giancarlotf/pi3a/Unity/simimg.jpeg

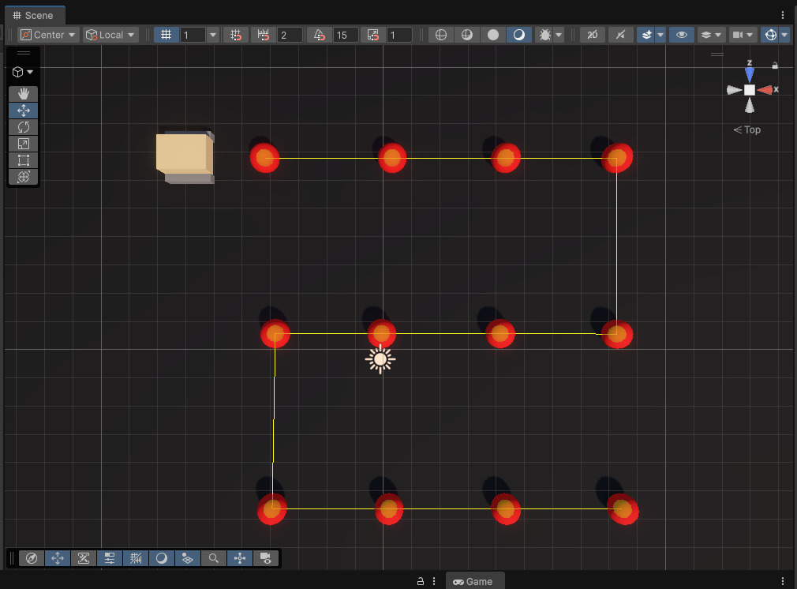
Unity/simimg.jpeg
