giancarlotf/pi3a/Fusion360/3d-models/Disco_Rodagem.step

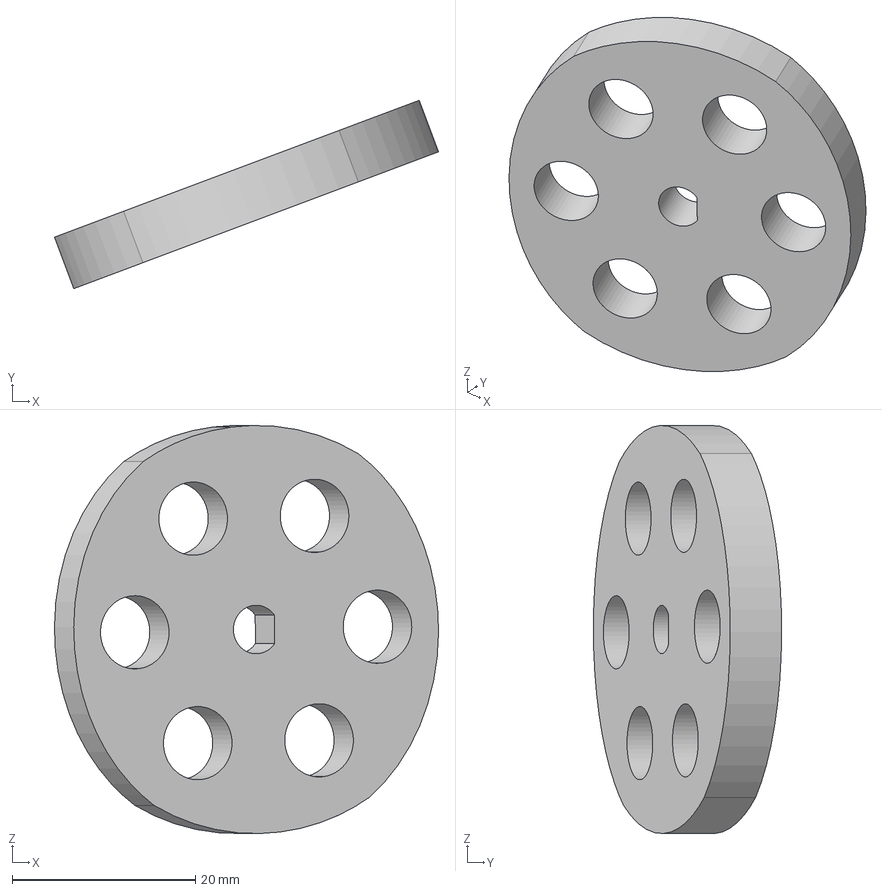
[picture p7: CAD file, 2026-06-23]
Fusion360/3d-models/Disco_Rodagem.step
42.0 x 20.6 x 44.6 mm
