giancarlotf/pi3a/KiCad/ESP8266-01_ESP-01/ESP8266-01_ESP-01.step

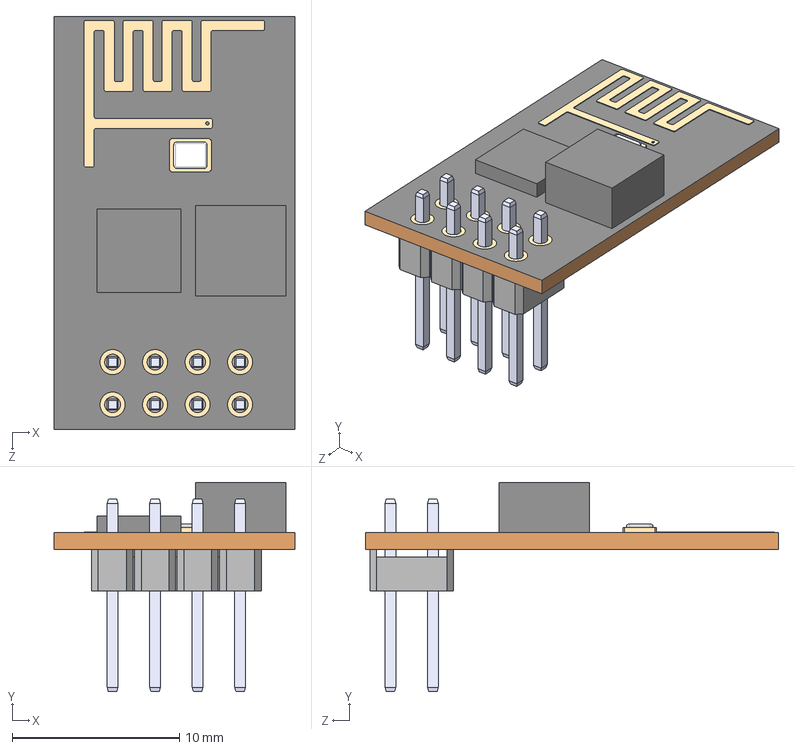
[picture p8: CAD file, 2026-05-04]
KiCad/ESP8266-01_ESP-01/ESP8266-01_ESP-01.step
14.4 x 12.5 x 24.7 mm
