giancarlotf/pi3a/KiCad/HC-SR04/HC-SR04.step

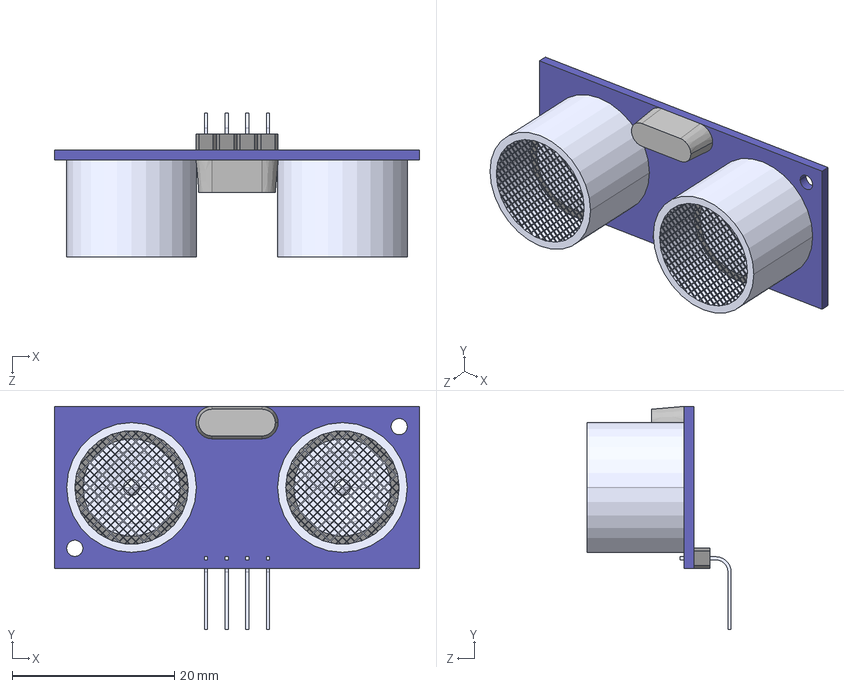
[picture p9: CAD file, 2026-05-04]
KiCad/HC-SR04/HC-SR04.step
45.0 x 27.5 x 17.8 mm
