giancarlotf/pi3a/Fusion360/3d-models/Suporte_Eixo_Disco.step

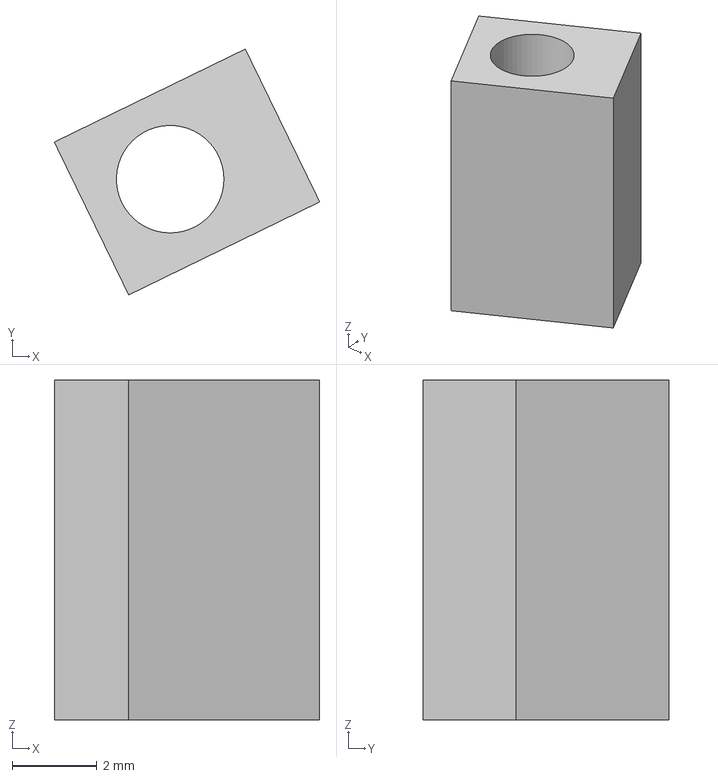
[picture p10: CAD file, 2026-06-23]
Fusion360/3d-models/Suporte_Eixo_Disco.step
6.25 x 5.79 x 8.00 mm
