giancarlotf/pi3a/Fusion360/3d-models/Haste_Disco.step

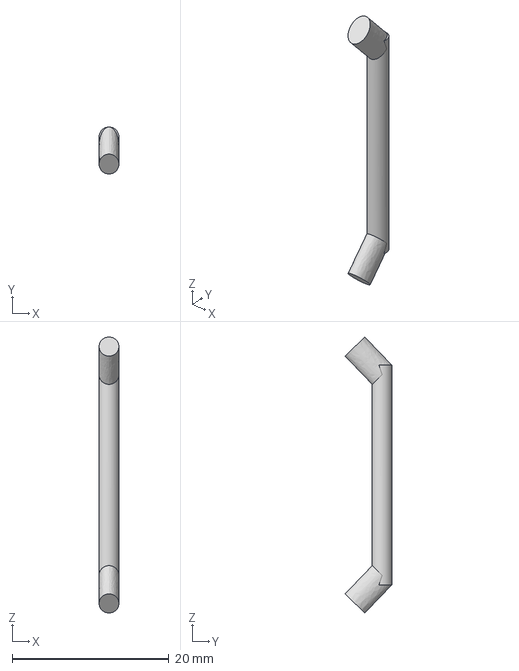
[picture p11: CAD file, 2026-06-23]
Fusion360/3d-models/Haste_Disco.step
2.53 x 5.99 x 35.2 mm
