giancarlotf/pi3a/Fusion360/3d-models/Tampa_Funil (1).step

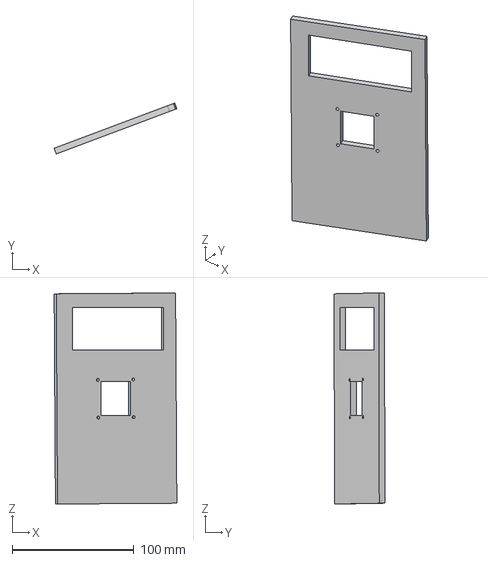
[picture p12: CAD file, 2026-06-23]
Fusion360/3d-models/Tampa_Funil (1).step
100.9 x 41.9 x 173.4 mm
