giancarlotf/pi3a/Fusion360/3d-models/Pa.step

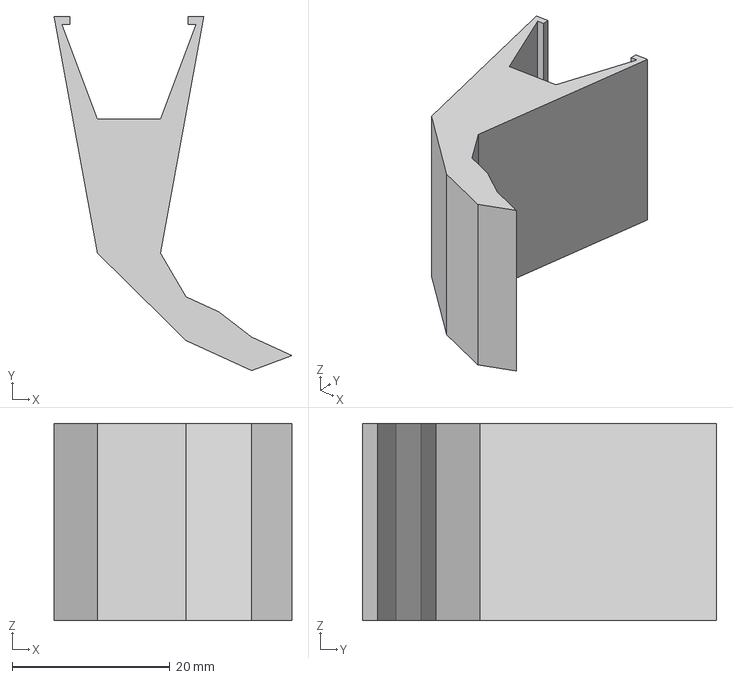
[picture p13: CAD file, 2026-06-23]
Fusion360/3d-models/Pa.step
30.2 x 44.9 x 25.0 mm
