giancarlotf/pi3a/Fusion360/3d-models/Funil.step

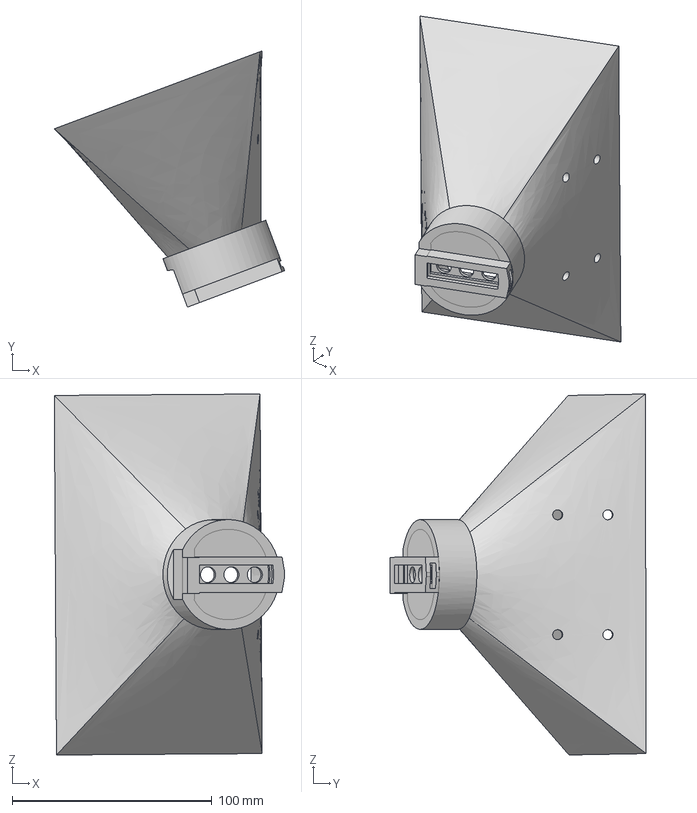
[picture p14: CAD file, 2026-06-23]
Fusion360/3d-models/Funil.step
115.3 x 128.3 x 180.7 mm
