giancarlotf/pi3a/Fusion360/3d-models/Eixo_Discos.step

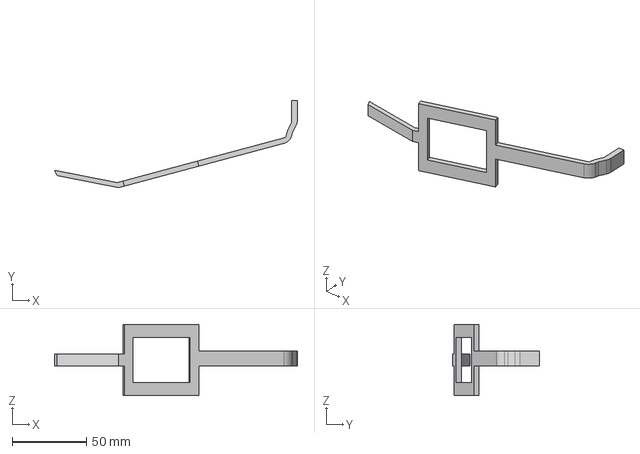
[picture p15: CAD file, 2026-06-23]
Fusion360/3d-models/Eixo_Discos.step
163.7 x 58.9 x 48.0 mm
