giancarlotf/pi3a/Fusion360/3d-models/Encaixe_Pa.step

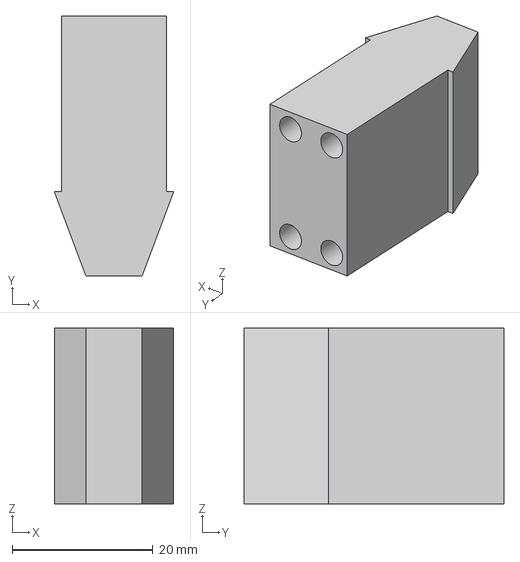
[picture p16: CAD file, 2026-06-23]
Fusion360/3d-models/Encaixe_Pa.step
17.0 x 37.0 x 25.0 mm
