giancarlotf/pi3a/Fusion360/3d-models/Discos.step

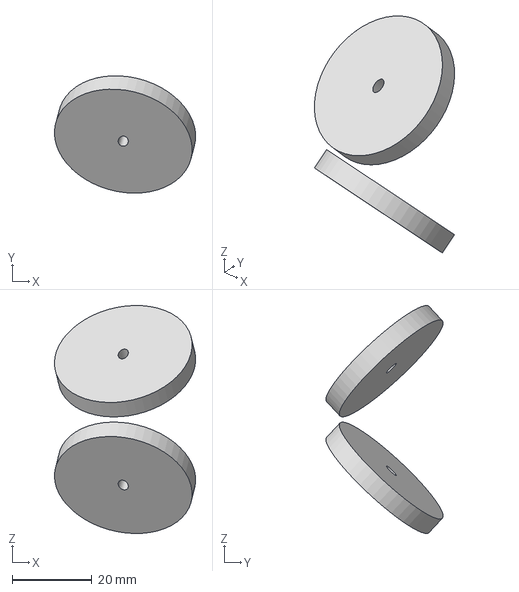
[picture p17: CAD file, 2026-06-23]
Fusion360/3d-models/Discos.step
35.3 x 29.3 x 57.0 mm
