giancarlotf/pi3a/Fusion360/3d-models/Eixo_Maior_Motor.step

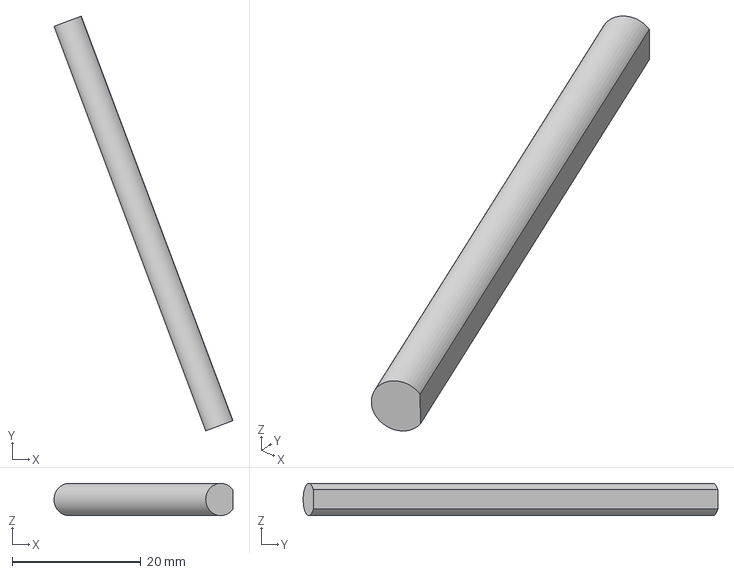
[picture p18: CAD file, 2026-06-23]
Fusion360/3d-models/Eixo_Maior_Motor.step
27.8 x 64.3 x 4.99 mm
