giancarlotf/pi3a/Fusion360/3d-models/Porta_Saida_Sementes.step

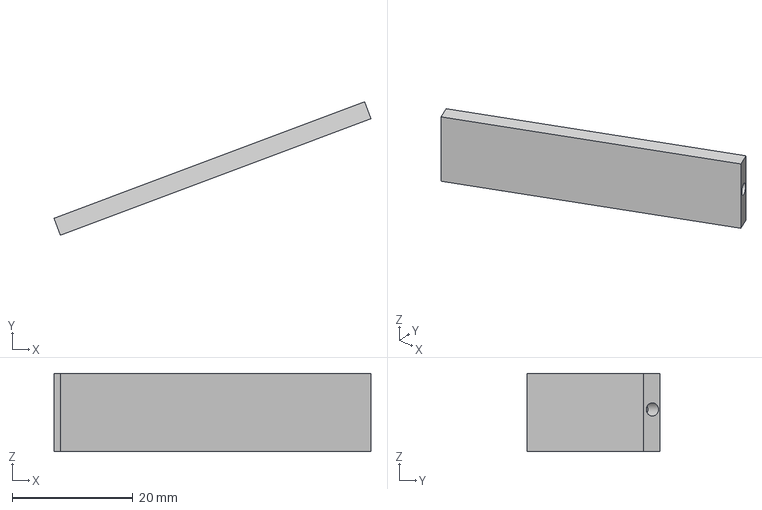
[picture p19: CAD file, 2026-06-23]
Fusion360/3d-models/Porta_Saida_Sementes.step
52.6 x 22.1 x 13.0 mm
