giancarlotf/pi3a/Fusion360/3d-models/Suporte_Base_Funil.step

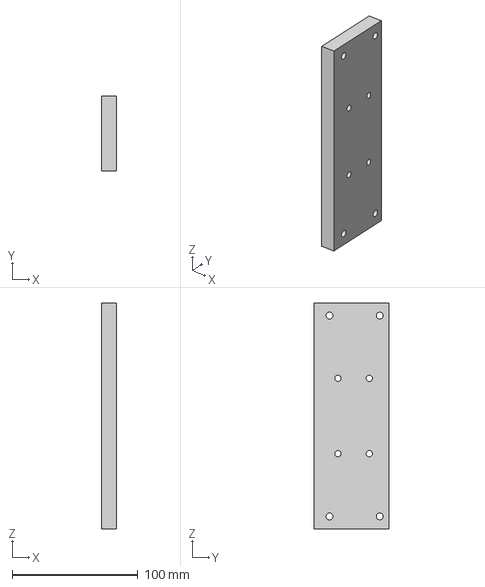
[picture p20: CAD file, 2026-06-23]
Fusion360/3d-models/Suporte_Base_Funil.step
12.0 x 60.0 x 180.0 mm
