giancarlotf/pi3a/Fusion360/3d-models/Base_Tampa_Funil.step

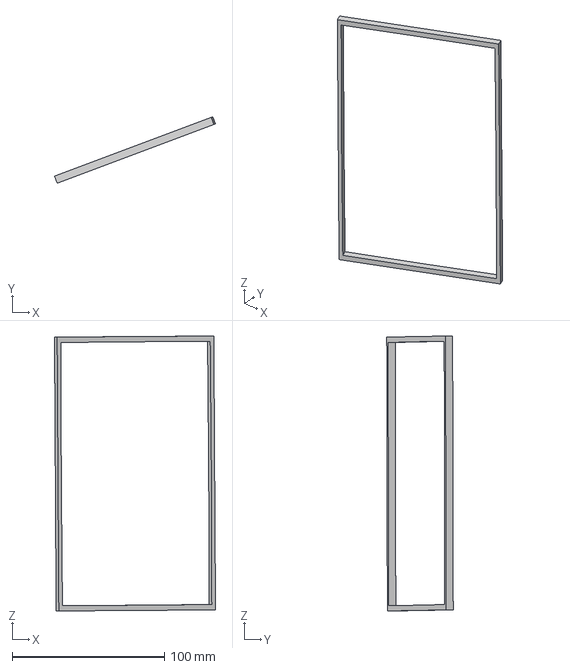
[picture p21: CAD file, 2026-06-23]
Fusion360/3d-models/Base_Tampa_Funil.step
105.8 x 43.7 x 180.7 mm
