giancarlotf/pi3a/Fusion360/3d-models/Eixo_Menor_Motor.step

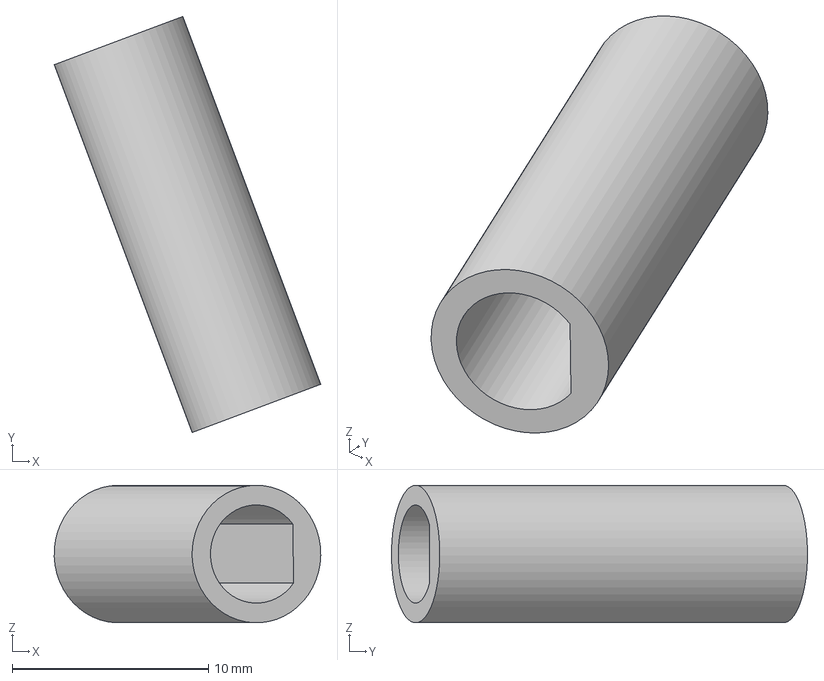
[picture p22: CAD file, 2026-06-23]
Fusion360/3d-models/Eixo_Menor_Motor.step
13.6 x 21.2 x 7.00 mm
