giancarlotf/pi3a/Fusion360/3d-models/Lateral_Esquerda.step

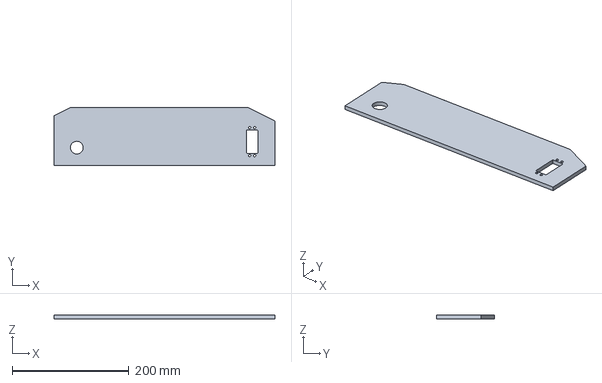
[picture p23: CAD file, 2026-05-29]
Fusion360/3d-models/Lateral_Esquerda.step
378.0 x 100.0 x 6.00 mm
