giancarlotf/pi3a/Fusion360/3d-models/Eixo_RoleteCarga.step

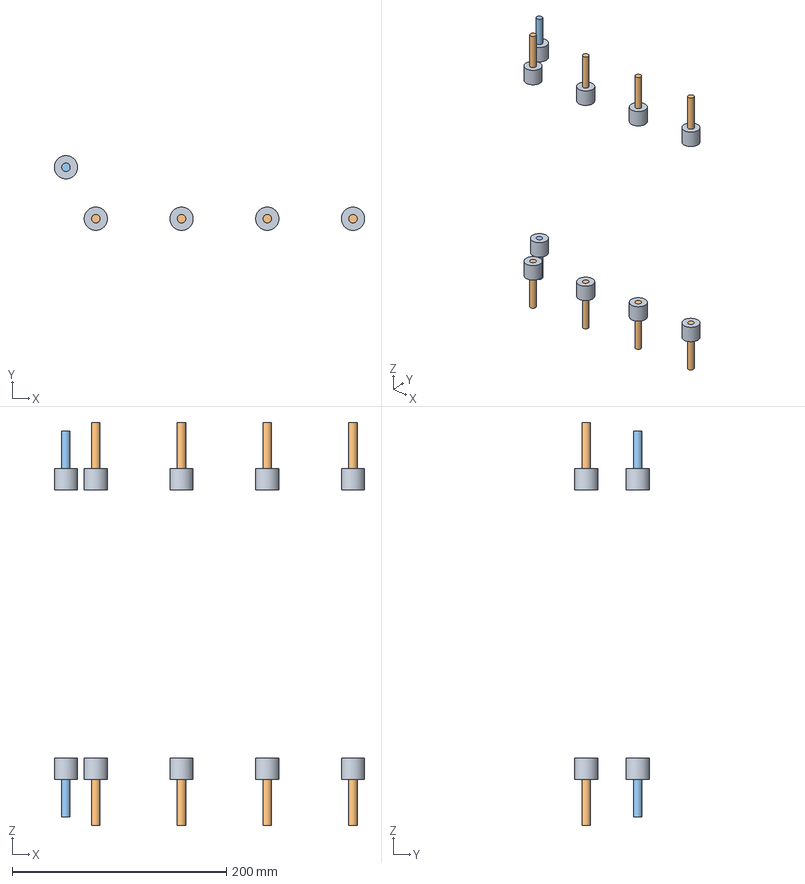
[picture p24: CAD file, 2026-05-29]
Fusion360/3d-models/Eixo_RoleteCarga.step
289.6 x 69.8 x 376.0 mm
