giancarlotf/pi3a/Fusion360/3d-models/Base_Esteira.step

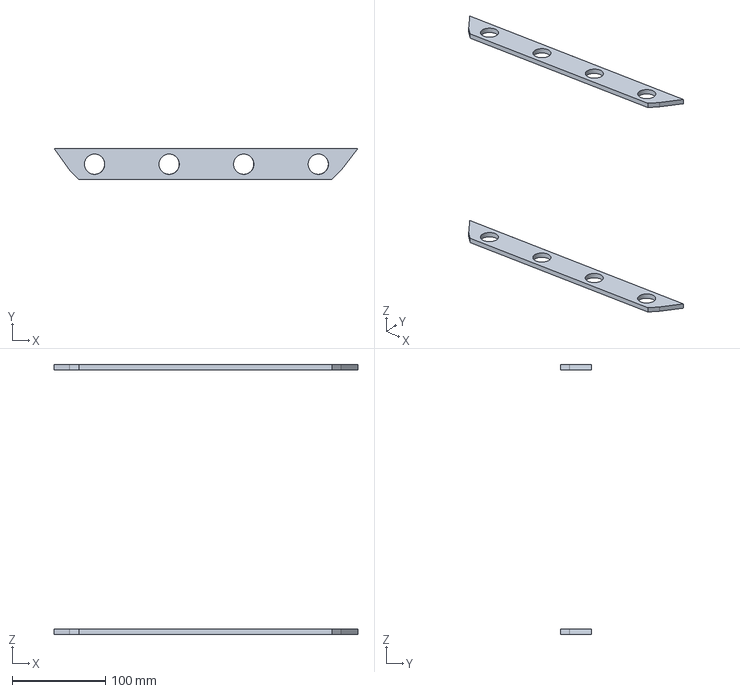
[picture p25: CAD file, 2026-05-29]
Fusion360/3d-models/Base_Esteira.step
326.1 x 33.5 x 290.0 mm
