giancarlotf/pi3a/Fusion360/3d-models/Eixo_SubEixo_Motor.step

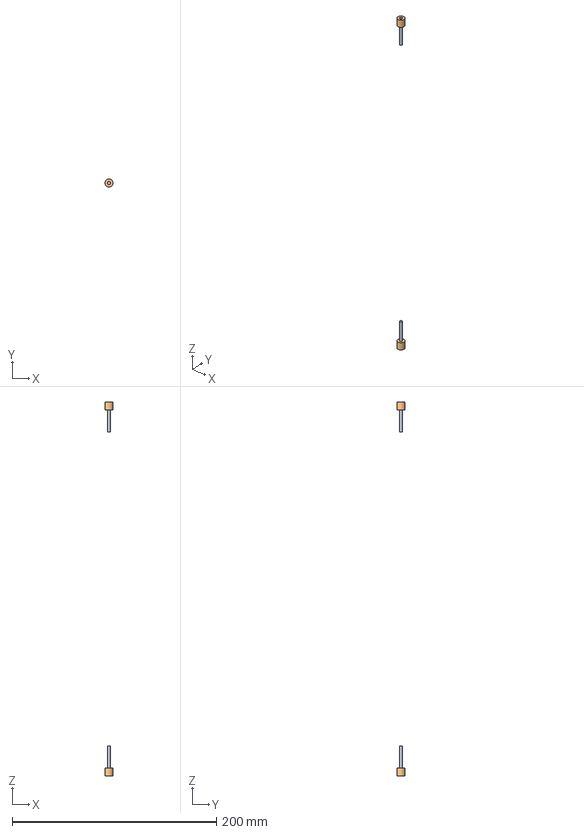
[picture p26: CAD file, 2026-05-29]
Fusion360/3d-models/Eixo_SubEixo_Motor.step
7.99 x 8.00 x 366.2 mm
