giancarlotf/pi3a/Fusion360/3d-models/Rolamentos.step

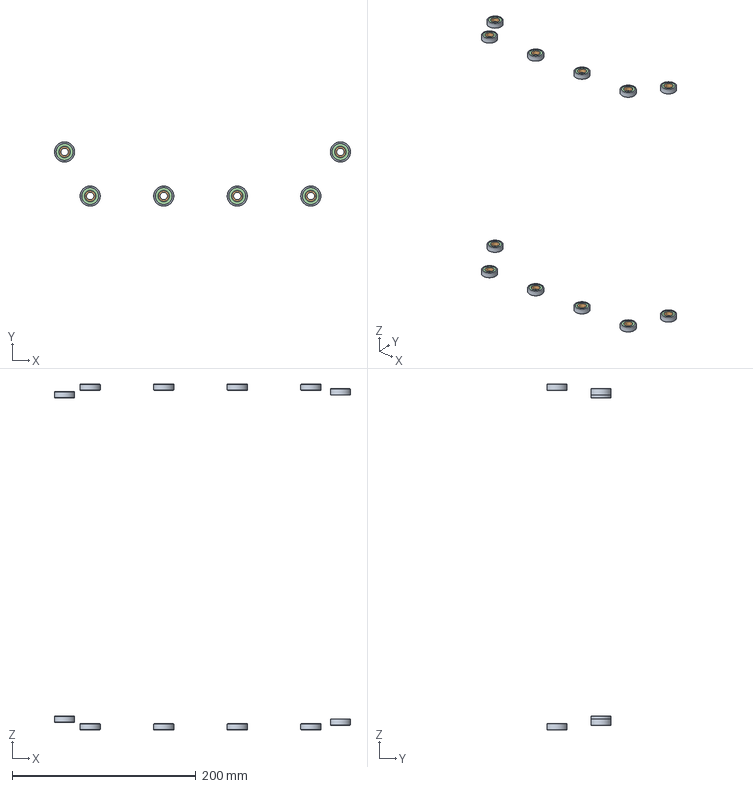
[picture p27: CAD file, 2026-05-29]
Fusion360/3d-models/Rolamentos.step
322.0 x 70.0 x 376.4 mm
