giancarlotf/pi3a/Fusion360/3d-models/Engrenagens_Sup.step

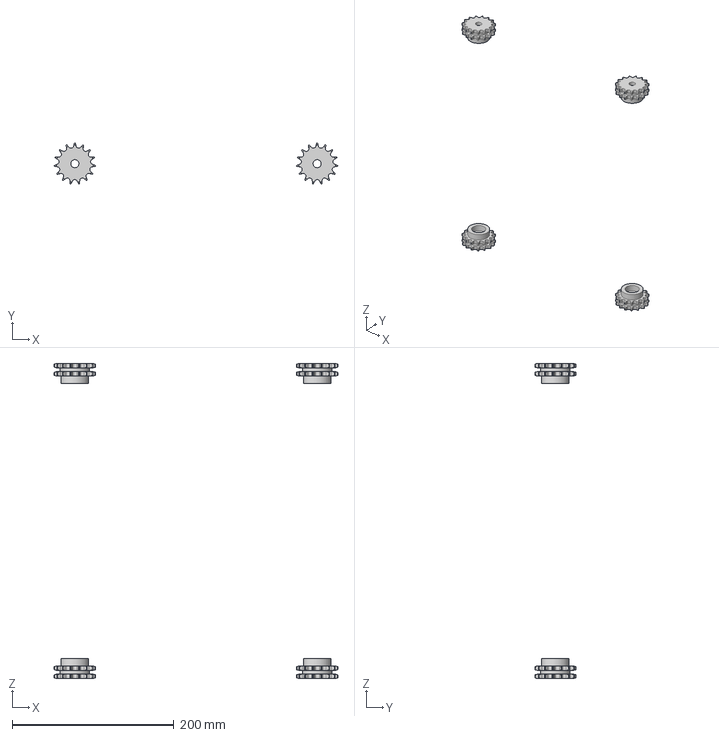
[picture p28: CAD file, 2026-05-29]
Fusion360/3d-models/Engrenagens_Sup.step
351.1 x 50.8 x 390.0 mm
