giancarlotf/pi3a/Fusion360/3d-models/Esteira.step

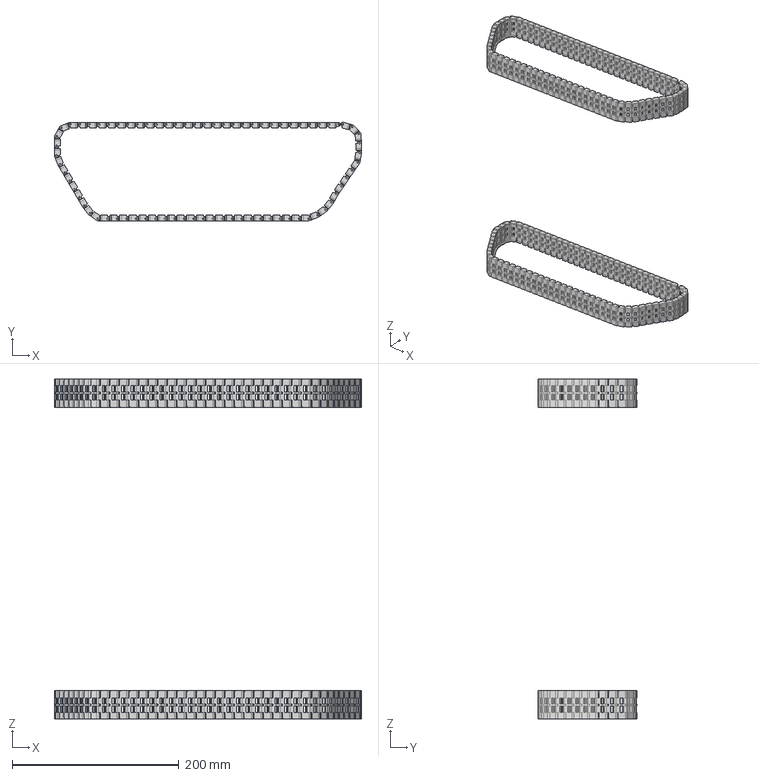
[picture p29: CAD file, 2026-05-29]
Fusion360/3d-models/Esteira.step
368.6 x 118.4 x 408.0 mm
