giancarlotf/pi3a/Fusion360/3d-models/Caixa_Eletronica.step

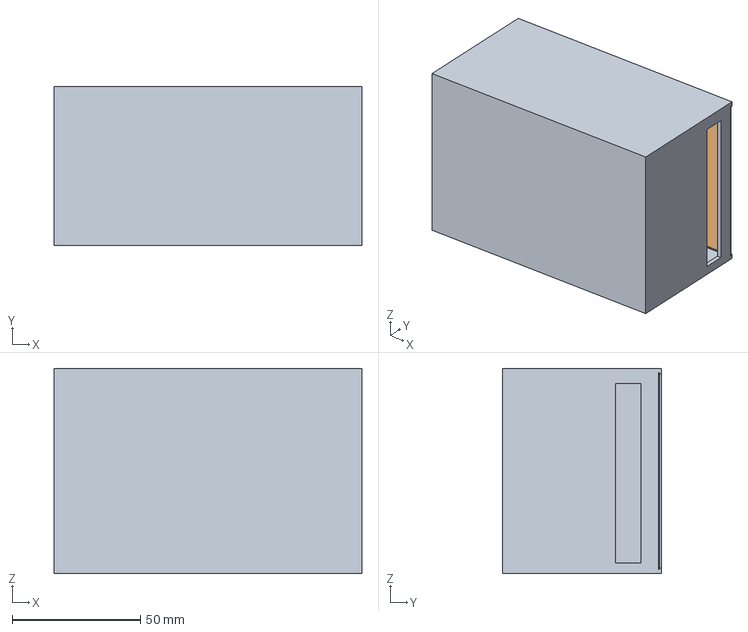
[picture p30: CAD file, 2026-05-29]
Fusion360/3d-models/Caixa_Eletronica.step
120.0 x 62.0 x 80.0 mm
