giancarlotf/pi3a/Fusion360/3d-models/Servo+MG996R.step

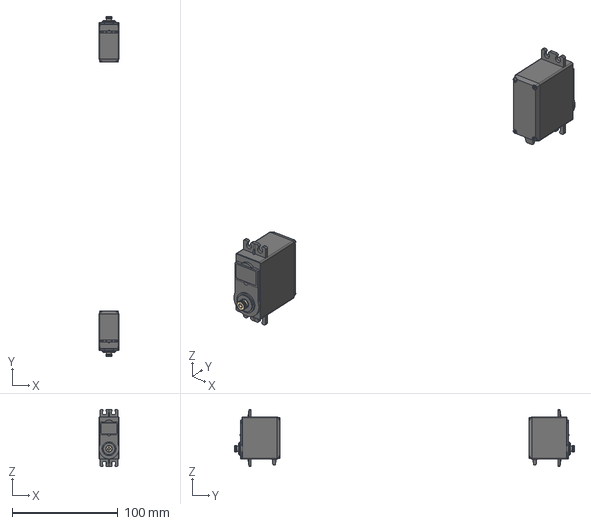
[picture p31: CAD file, 2026-05-29]
Fusion360/3d-models/Servo+MG996R.step
19.0 x 321.4 x 54.0 mm
