giancarlotf/pi3a/Fusion360/3d-models/Engrenagens_Inf.step

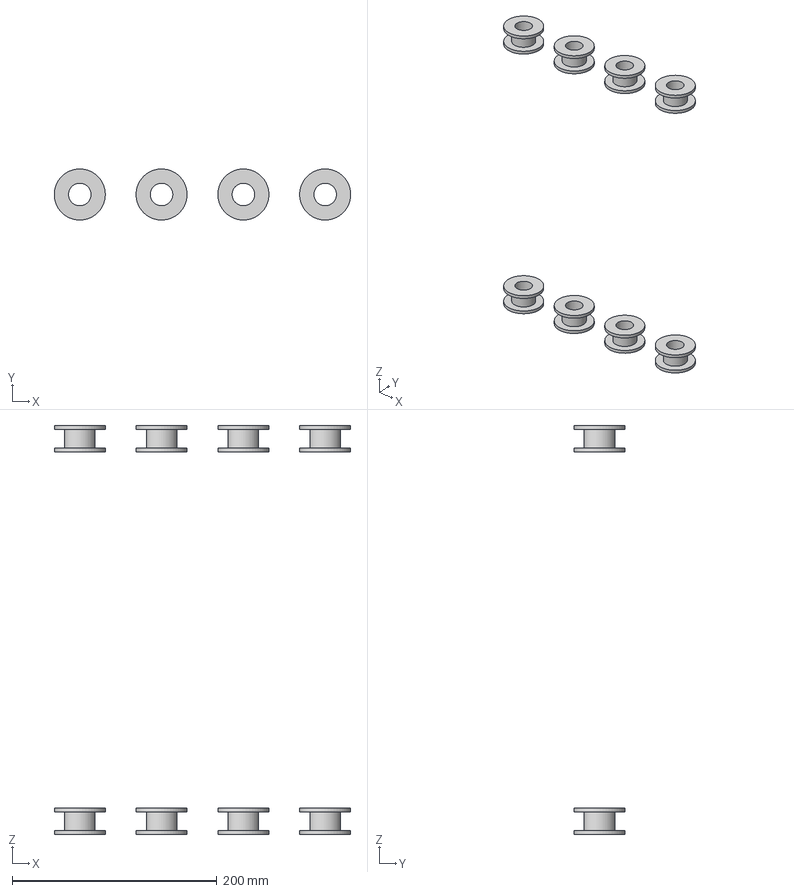
[picture p32: CAD file, 2026-05-29]
Fusion360/3d-models/Engrenagens_Inf.step
290.0 x 50.0 x 400.0 mm
