giancarlotf/pi3a/Fusion360/3d-models/Parede_Traseira.step

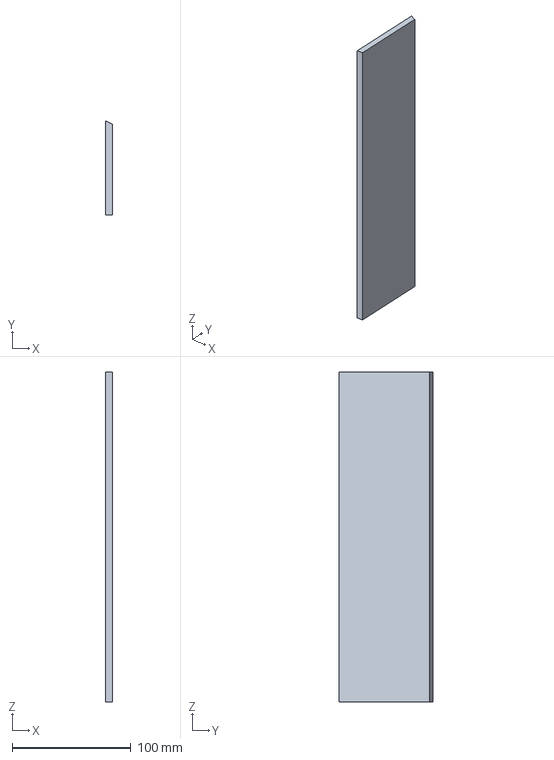
[picture p33: CAD file, 2026-05-29]
Fusion360/3d-models/Parede_Traseira.step
6.00 x 79.5 x 278.0 mm
