giancarlotf/pi3a/Fusion360/3d-models/Parede_Frontal.step

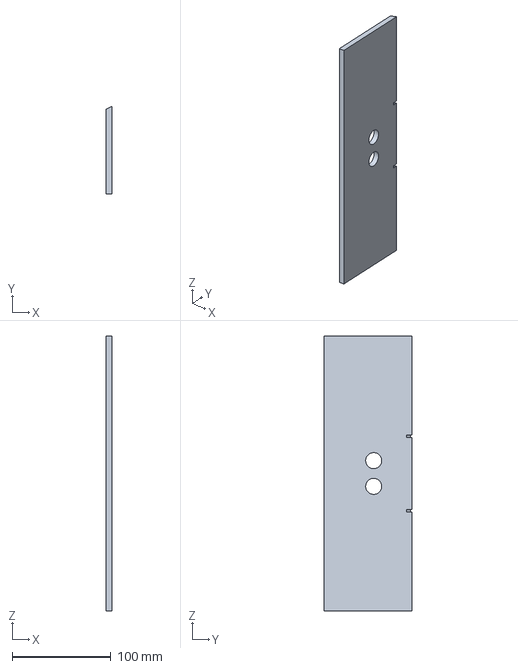
[picture p34: CAD file, 2026-05-29]
Fusion360/3d-models/Parede_Frontal.step
6.00 x 88.5 x 278.0 mm
