giancarlotf/pi3a/Fusion360/3d-models/tampa.step

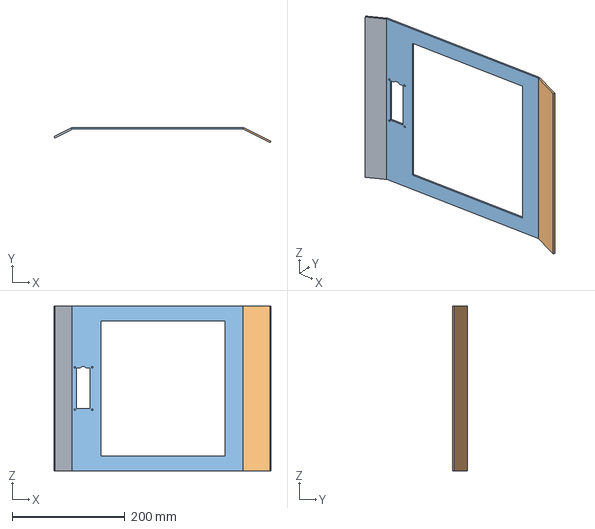
[picture p35: CAD file, 2026-05-29]
Fusion360/3d-models/tampa.step
384.8 x 27.1 x 292.0 mm
