giancarlotf/pi3a/Fusion360/3d-models/Chassi_Base.step

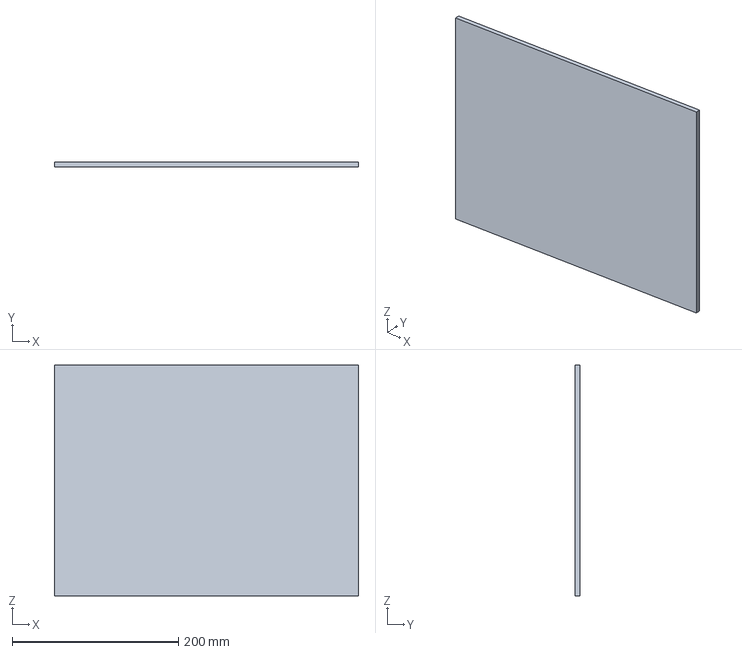
[picture p36: CAD file, 2026-05-29]
Fusion360/3d-models/Chassi_Base.step
366.0 x 6.00 x 278.0 mm
