giancarlotf/pi3a/(list of files, cad)

Other CAD files:
Fusion360/3d-models/Lateral_Direita.step
KiCad/OC09600/OC09600.step
