giancarlotf/pi3a/Fusion360/PROJETO ROBÔ SEMEADOR (PI3A - IESB) Desenho.pdf

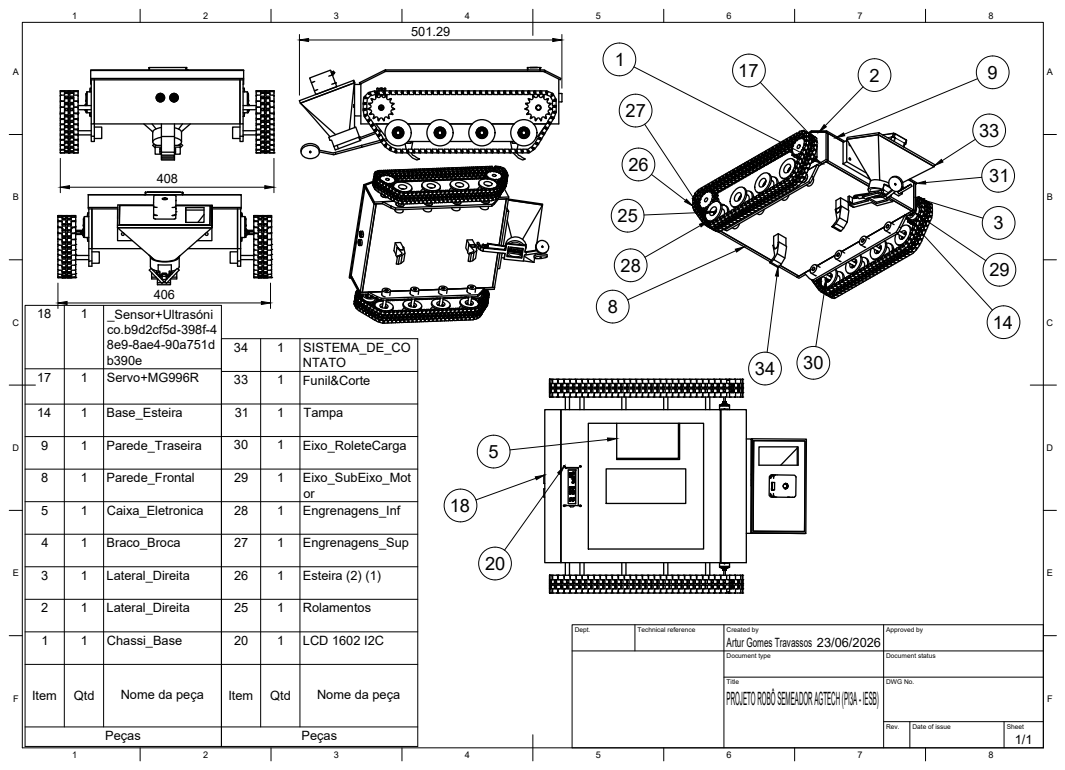
[picture p37: page 1]
Dept.; Technical reference; Created by; Approved by; Document type; Document status; Title; DWG No.; Rev.; Date of issue; Sheet; Item; Qtd; Nome da peça; LCD 1602 I2C; Esteira (2) (1)

Artur Gomes Travassos

PROJETO ROBÔ SEMEADOR AGTECH (PI3A - IESB)
