giancarlotf/pi3a/KiCad/projeto/projeto.kicad_pcb

## KiCad design pcb_eval/gb_emu_eval.kicad_sch


Parts:
J1: CN7
J2: CN10
J3: CN6
J4: CN9
J5: CN8
J6: CN5
