giancarlotf/pi3a/(commit log)

2026-05-29 PROJETO ROBÔ SEMEADOR (PI3A - IESB)
    [Base_Esteira.step, Caixa_Eletronica.step, Chassi_Base.step, Eixo_RoleteCarga.step, Eixo_SubEixo_Motor.step, Engrenagens_Inf.step, Engrenagens_Sup.step, Esteira.step]
2026-05-29 add new .step files
    [Base_Esteira.step, Caixa_Eletronica.step, Chassi_Base.step, Eixo_RoleteCarga.step, Eixo_SubEixo_Motor.step, Engrenagens_Inf.step, Engrenagens_Sup.step, Esteira.step]
2026-05-29 add new project files
    [Base_Esteira.step, Caixa_Eletronica.step, Chassi_Base.step, Eixo_RoleteCarga.step, Eixo_SubEixo_Motor.step, Engrenagens_Inf.step, Engrenagens_Sup.step, Esteira.step]
2026-06-23 Changed STEP files' path
    [Disco_Rodagem.step, Discos.step, Eixo_Discos.step, Eixo_Maior_Motor.step, Eixo_Menor_Motor.step, Eixo_RoleteCarga.step, Eixo_SubEixo_Motor.step, Encaixe_Pa.step]
